alexandergdot123/warp-simd-fpga-gpu/media/Screenshot 2026-07-18 125612.png

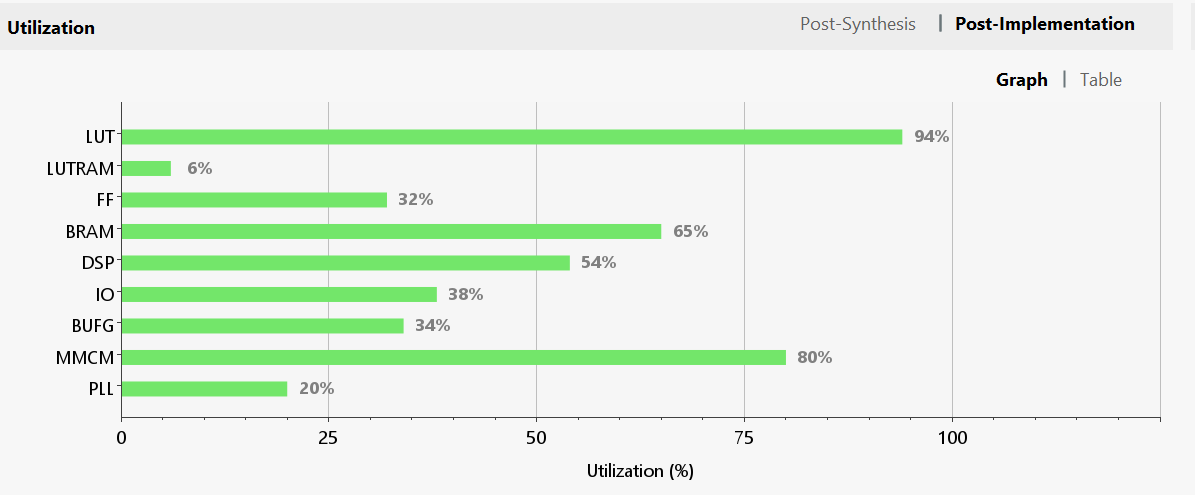
media/Screenshot 2026-07-18 125612.png
