alexandergdot123/warp-simd-fpga-gpu/hw/fullSystemTop.xdc

create_clock -period 10.000 -name clk_100 -waveform {0.000 5.000} [get_ports Clk]
# =========================
# GPU clock (clk_slow_creator)
# =========================
create_generated_clock -name gpu_clk -source [get_pins clk_slow_creator_inst/inst/clk_in1] [get_pins clk_slow_creator_inst/inst/clk_out1]

set_clock_groups -asynchronous -group [get_clocks gpu_clk] -group [get_clocks -exclude gpu_clk *]

set_property IOSTANDARD LVCMOS33 [get_ports Clk]
set_property IOSTANDARD LVCMOS25 [get_ports reset_rtl_0]
set_property IOSTANDARD LVCMOS33 [get_ports uart_rtl_0_rxd]
set_property IOSTANDARD LVCMOS33 [get_ports uart_rtl_0_txd]
set_property PACKAGE_PIN N15 [get_ports Clk]
set_property PACKAGE_PIN J2 [get_ports reset_rtl_0]
set_property PACKAGE_PIN B16 [get_ports uart_rtl_0_rxd]
set_property PACKAGE_PIN A16 [get_ports uart_rtl_0_txd]

set_property IOSTANDARD LVCMOS33 [get_ports {gpio_usb_int_tri_i[0]}]
set_property IOSTANDARD LVCMOS33 [get_ports usb_spi_miso]
set_property IOSTANDARD LVCMOS33 [get_ports usb_spi_mosi]
set_property IOSTANDARD LVCMOS33 [get_ports usb_spi_sclk]
set_property PACKAGE_PIN T13 [get_ports {gpio_usb_int_tri_i[0]}]
set_property PACKAGE_PIN V14 [get_ports usb_spi_sclk]
set_property PACKAGE_PIN V15 [get_ports usb_spi_mosi]
set_property PACKAGE_PIN U12 [get_ports usb_spi_miso]

set_property IOSTANDARD LVCMOS33 [get_ports gpio_usb_rst_tri_o]
set_property PACKAGE_PIN V13 [get_ports gpio_usb_rst_tri_o]
set_property PACKAGE_PIN T12 [get_ports usb_spi_ss]
set_property IOSTANDARD LVCMOS33 [get_ports usb_spi_ss]


#HDMI Signals
set_property -dict {PACKAGE_PIN V17 IOSTANDARD TMDS_33} [get_ports hdmi_tmds_clk_n]
set_property -dict {PACKAGE_PIN U16 IOSTANDARD TMDS_33} [get_ports hdmi_tmds_clk_p]

set_property -dict {PACKAGE_PIN U18 IOSTANDARD TMDS_33} [get_ports {hdmi_tmds_data_n[0]}]
set_property -dict {PACKAGE_PIN R17 IOSTANDARD TMDS_33} [get_ports {hdmi_tmds_data_n[1]}]
set_property -dict {PACKAGE_PIN T14 IOSTANDARD TMDS_33} [get_ports {hdmi_tmds_data_n[2]}]

set_property -dict {PACKAGE_PIN U17 IOSTANDARD TMDS_33} [get_ports {hdmi_tmds_data_p[0]}]
set_property -dict {PACKAGE_PIN R16 IOSTANDARD TMDS_33} [get_ports {hdmi_tmds_data_p[1]}]
set_property -dict {PACKAGE_PIN R14 IOSTANDARD TMDS_33} [get_ports {hdmi_tmds_data_p[2]}]














##################################################################################################
## LP_DDR3 INTERFACE FOR THE URBANA BOARD based on the July 18 2022 schematic
## Memory Device: DDR3_SDRAM->Components->MT41K256M16XX-15E
## Data Width: 16
## Time Period: 2500
## Data Mask: 1
## Rick Ballantyne AMD July25 2022 NOT HARDWARE VERIFIED
##################################################################################################
############## NET - IOSTANDARD ##################

# PadFunction: IO_L12P_T1_MRCC_14 (SCHEMATIC CLK_100MHZ)
#set_property IOSTANDARD LVCMOS33 [get_ports clk_ref_i]
#set_property PACKAGE_PIN N15 [get_ports clk_ref_i] #overlap
#create_clock -period 10.000 [get_ports clk_ref_i]


# PadFunction: IO_L12N_T1_MRCC_16 (SCHEMATIC RGB0_G)
set_property IOSTANDARD LVCMOS33 [get_ports ram_init_done]
set_property PACKAGE_PIN A9 [get_ports ram_init_done]

# PadFunction: IO_L14N_T2_SRCC_16 (SCHEMATIC RGB1_R)
set_property IOSTANDARD LVCMOS33 [get_ports ram_init_error]
set_property PACKAGE_PIN A11 [get_ports ram_init_error]

# Set SPI buswidth
set_property BITSTREAM.CONFIG.SPI_BUSWIDTH 4 [current_design]

set_property -dict {PACKAGE_PIN M16 IOSTANDARD LVCMOS33} [get_ports sd_miso]
set_property -dict {PACKAGE_PIN N18 IOSTANDARD LVCMOS33} [get_ports sd_cs]
set_property -dict {PACKAGE_PIN P17 IOSTANDARD LVCMOS33} [get_ports sd_mosi]
set_property -dict {PACKAGE_PIN P18 IOSTANDARD LVCMOS33} [get_ports sd_sclk]

# PadFunction: IO_L1N_T0_34 (SCHEMATIC DDR_DQ0)
set_property SLEW FAST [get_ports {ddr3_dq[0]}]
set_property IN_TERM UNTUNED_SPLIT_50 [get_ports {ddr3_dq[0]}]
set_property IOSTANDARD SSTL135 [get_ports {ddr3_dq[0]}]
set_property PACKAGE_PIN K2 [get_ports {ddr3_dq[0]}]

# PadFunction: IO_L2P_T0_34 (SCHEMATIC DDR_DQ1)
set_property SLEW FAST [get_ports {ddr3_dq[1]}]
set_property IN_TERM UNTUNED_SPLIT_50 [get_ports {ddr3_dq[1]}]
set_property IOSTANDARD SSTL135 [get_ports {ddr3_dq[1]}]
set_property PACKAGE_PIN M4 [get_ports {ddr3_dq[1]}]

# PadFunction: IO_L2N_T0_34 (SCHEMATIC DDR_DQ2)
set_property SLEW FAST [get_ports {ddr3_dq[2]}]
set_property IN_TERM UNTUNED_SPLIT_50 [get_ports {ddr3_dq[2]}]
set_property IOSTANDARD SSTL135 [get_ports {ddr3_dq[2]}]
set_property PACKAGE_PIN K3 [get_ports {ddr3_dq[2]}]

# PadFunction: IO_L4P_T0_34 (SCHEMATIC DDR_DQ3)
set_property SLEW FAST [get_ports {ddr3_dq[3]}]
set_property IN_TERM UNTUNED_SPLIT_50 [get_ports {ddr3_dq[3]}]
set_property IOSTANDARD SSTL135 [get_ports {ddr3_dq[3]}]
set_property PACKAGE_PIN L5 [get_ports {ddr3_dq[3]}]

# PadFunction: IO_L4N_T0_34 (SCHEMATIC DDR_DQ4)
set_property SLEW FAST [get_ports {ddr3_dq[4]}]
set_property IN_TERM UNTUNED_SPLIT_50 [get_ports {ddr3_dq[4]}]
set_property IOSTANDARD SSTL135 [get_ports {ddr3_dq[4]}]
set_property PACKAGE_PIN L6 [get_ports {ddr3_dq[4]}]

# PadFunction: IO_L5P_T0_34 (SCHEMATIC DDR_DQ5)
set_property SLEW FAST [get_ports {ddr3_dq[5]}]
set_property IN_TERM UNTUNED_SPLIT_50 [get_ports {ddr3_dq[5]}]
set_property IOSTANDARD SSTL135 [get_ports {ddr3_dq[5]}]
set_property PACKAGE_PIN M6 [get_ports {ddr3_dq[5]}]

# PadFunction: IO_L5N_T0_34 (SCHEMATIC DDR_DQ6)
set_property SLEW FAST [get_ports {ddr3_dq[6]}]
set_property IN_TERM UNTUNED_SPLIT_50 [get_ports {ddr3_dq[6]}]
set_property IOSTANDARD SSTL135 [get_ports {ddr3_dq[6]}]
set_property PACKAGE_PIN L4 [get_ports {ddr3_dq[6]}]

# PadFunction: IO_L6P_T0_34 (SCHEMATIC DDR_DQ7)
set_property SLEW FAST [get_ports {ddr3_dq[7]}]
set_property IN_TERM UNTUNED_SPLIT_50 [get_ports {ddr3_dq[7]}]
set_property IOSTANDARD SSTL135 [get_ports {ddr3_dq[7]}]
set_property PACKAGE_PIN K6 [get_ports {ddr3_dq[7]}]

# PadFunction: IO_L7N_T1_34 (SCHEMATIC DDR_DQ8)
set_property SLEW FAST [get_ports {ddr3_dq[8]}]
set_property IN_TERM UNTUNED_SPLIT_50 [get_ports {ddr3_dq[8]}]
set_property IOSTANDARD SSTL135 [get_ports {ddr3_dq[8]}]
set_property PACKAGE_PIN N5 [get_ports {ddr3_dq[8]}]

# PadFunction: IO_L8P_T1_34 (SCHEMATIC DDR_DQ9)
set_property SLEW FAST [get_ports {ddr3_dq[9]}]
set_property IN_TERM UNTUNED_SPLIT_50 [get_ports {ddr3_dq[9]}]
set_property IOSTANDARD SSTL135 [get_ports {ddr3_dq[9]}]
set_property PACKAGE_PIN M1 [get_ports {ddr3_dq[9]}]

# PadFunction: IO_L8N_T1_34 (SCHEMATIC DDR_DQ10)
set_property SLEW FAST [get_ports {ddr3_dq[10]}]
set_property IN_TERM UNTUNED_SPLIT_50 [get_ports {ddr3_dq[10]}]
set_property IOSTANDARD SSTL135 [get_ports {ddr3_dq[10]}]
set_property PACKAGE_PIN P1 [get_ports {ddr3_dq[10]}]

# PadFunction: IO_L10P_T1_34 (SCHEMATIC DDR_DQ11)
set_property SLEW FAST [get_ports {ddr3_dq[11]}]
set_property IN_TERM UNTUNED_SPLIT_50 [get_ports {ddr3_dq[11]}]
set_property IOSTANDARD SSTL135 [get_ports {ddr3_dq[11]}]
set_property PACKAGE_PIN N1 [get_ports {ddr3_dq[11]}]

# PadFunction: IO_L10N_T1_34 (SCHEMATIC DDR_DQ12)
set_property SLEW FAST [get_ports {ddr3_dq[12]}]
set_property IN_TERM UNTUNED_SPLIT_50 [get_ports {ddr3_dq[12]}]
set_property IOSTANDARD SSTL135 [get_ports {ddr3_dq[12]}]
set_property PACKAGE_PIN R2 [get_ports {ddr3_dq[12]}]

# PadFunction: IO_L11P_T1_SRCC_34 (SCHEMATIC DDR_DQ13)
set_property SLEW FAST [get_ports {ddr3_dq[13]}]
set_property IN_TERM UNTUNED_SPLIT_50 [get_ports {ddr3_dq[13]}]
set_property IOSTANDARD SSTL135 [get_ports {ddr3_dq[13]}]
set_property PACKAGE_PIN N4 [get_ports {ddr3_dq[13]}]

# PadFunction: IO_L11N_T1_SRCC_34 (SCHEMATIC DDR_DQ14)
set_property SLEW FAST [get_ports {ddr3_dq[14]}]
set_property IN_TERM UNTUNED_SPLIT_50 [get_ports {ddr3_dq[14]}]
set_property IOSTANDARD SSTL135 [get_ports {ddr3_dq[14]}]
set_property PACKAGE_PIN P2 [get_ports {ddr3_dq[14]}]

# PadFunction: IO_L12P_T1_MRCC_34 (SCHEMATIC DDR_DQ15)
set_property SLEW FAST [get_ports {ddr3_dq[15]}]
set_property IN_TERM UNTUNED_SPLIT_50 [get_ports {ddr3_dq[15]}]
set_property IOSTANDARD SSTL135 [get_ports {ddr3_dq[15]}]
set_property PACKAGE_PIN M2 [get_ports {ddr3_dq[15]}]

# PadFunction: IO_L13P_T2_MRCC_34 (SCHEMATIC DDR_A14)
#set_property SLEW FAST [get_ports {ddr3_addr[14]}]
#set_property IOSTANDARD SSTL135 [get_ports {ddr3_addr[14]}]
#set_property PACKAGE_PIN R6 [get_ports {ddr3_addr[14]}]

# PadFunction: IO_L13N_T2_MRCC_34 (SCHEMATIC DDR_A13)
#set_property SLEW FAST [get_ports {ddr3_addr[13]}]
#set_property IOSTANDARD SSTL135 [get_ports {ddr3_addr[13]}]
#set_property PACKAGE_PIN V7 [get_ports {ddr3_addr[13]}]

# PadFunction: IO_L14P_T2_SRCC_34 (SCHEMATIC DDR_A12)
set_property SLEW FAST [get_ports {ddr3_addr[12]}]
set_property IOSTANDARD SSTL135 [get_ports {ddr3_addr[12]}]
set_property PACKAGE_PIN V6 [get_ports {ddr3_addr[12]}]

# PadFunction: IO_L14N_T2_SRCC_34 (SCHEMATIC DDR_A11)
set_property SLEW FAST [get_ports {ddr3_addr[11]}]
set_property IOSTANDARD SSTL135 [get_ports {ddr3_addr[11]}]
set_property PACKAGE_PIN P5 [get_ports {ddr3_addr[11]}]

# PadFunction: IO_L15P_T2_DQS_34 (SCHEMATIC DDR_A10)
set_property SLEW FAST [get_ports {ddr3_addr[10]}]
set_property IOSTANDARD SSTL135 [get_ports {ddr3_addr[10]}]
set_property PACKAGE_PIN U3 [get_ports {ddr3_addr[10]}]

# PadFunction: IO_L15N_T2_DQS_34 (SCHEMATIC DDR_A9)
set_property SLEW FAST [get_ports {ddr3_addr[9]}]
set_property IOSTANDARD SSTL135 [get_ports {ddr3_addr[9]}]
set_property PACKAGE_PIN U6 [get_ports {ddr3_addr[9]}]

# PadFunction: IO_L16P_T2_34 (SCHEMATIC DDR_A8)
set_property SLEW FAST [get_ports {ddr3_addr[8]}]
set_property IOSTANDARD SSTL135 [get_ports {ddr3_addr[8]}]
set_property PACKAGE_PIN R7 [get_ports {ddr3_addr[8]}]

# PadFunction: IO_L16N_T2_34 (SCHEMATIC DDR_A7)
set_property SLEW FAST [get_ports {ddr3_addr[7]}]
set_property IOSTANDARD SSTL135 [get_ports {ddr3_addr[7]}]
set_property PACKAGE_PIN U7 [get_ports {ddr3_addr[7]}]

# PadFunction: IO_L17P_T2_34 (SCHEMATIC DDR_A6)
set_property SLEW FAST [get_ports {ddr3_addr[6]}]
set_property IOSTANDARD SSTL135 [get_ports {ddr3_addr[6]}]
set_property PACKAGE_PIN V5 [get_ports {ddr3_addr[6]}]

# PadFunction: IO_L17N_T2_34 (SCHEMATIC DDR_A5)
set_property SLEW FAST [get_ports {ddr3_addr[5]}]
set_property IOSTANDARD SSTL135 [get_ports {ddr3_addr[5]}]
set_property PACKAGE_PIN T1 [get_ports {ddr3_addr[5]}]

# PadFunction: IO_L18P_T2_34 (SCHEMATIC DDR_A4)
set_property SLEW FAST [get_ports {ddr3_addr[4]}]
set_property IOSTANDARD SSTL135 [get_ports {ddr3_addr[4]}]
set_property PACKAGE_PIN T6 [get_ports {ddr3_addr[4]}]

# PadFunction: IO_L18N_T2_34 (SCHEMATIC DDR_A3)
set_property SLEW FAST [get_ports {ddr3_addr[3]}]
set_property IOSTANDARD SSTL135 [get_ports {ddr3_addr[3]}]
set_property PACKAGE_PIN T3 [get_ports {ddr3_addr[3]}]

# PadFunction: IO_L19P_T3_34 (SCHEMATIC DDR_A2)
set_property SLEW FAST [get_ports {ddr3_addr[2]}]
set_property IOSTANDARD SSTL135 [get_ports {ddr3_addr[2]}]
set_property PACKAGE_PIN P6 [get_ports {ddr3_addr[2]}]

# PadFunction: IO_L19N_T3_VREF_34 (SCHEMATIC DDR_A1)
set_property SLEW FAST [get_ports {ddr3_addr[1]}]
set_property IOSTANDARD SSTL135 [get_ports {ddr3_addr[1]}]
set_property PACKAGE_PIN R4 [get_ports {ddr3_addr[1]}]

# PadFunction: IO_L20P_T3_34 (SCHEMATIC DDR_A0)
set_property SLEW FAST [get_ports {ddr3_addr[0]}]
set_property IOSTANDARD SSTL135 [get_ports {ddr3_addr[0]}]
set_property PACKAGE_PIN V3 [get_ports {ddr3_addr[0]}]

# PadFunction: IO_L20N_T3_34 (SCHEMATIC DDR_BA2)
set_property SLEW FAST [get_ports {ddr3_ba[2]}]
set_property IOSTANDARD SSTL135 [get_ports {ddr3_ba[2]}]
set_property PACKAGE_PIN R3 [get_ports {ddr3_ba[2]}]

# PadFunction: IO_L22P_T3_34 (SCHEMATIC DDR_BA1)
set_property SLEW FAST [get_ports {ddr3_ba[1]}]
set_property IOSTANDARD SSTL135 [get_ports {ddr3_ba[1]}]
set_property PACKAGE_PIN V4 [get_ports {ddr3_ba[1]}]

# PadFunction: IO_L22N_T3_34 (SCHEMATIC DDR_BA0)
set_property SLEW FAST [get_ports {ddr3_ba[0]}]
set_property IOSTANDARD SSTL135 [get_ports {ddr3_ba[0]}]
set_property PACKAGE_PIN V2 [get_ports {ddr3_ba[0]}]

# PadFunction: IO_L23P_T3_34 (SCHEMATIC DDR_RAS_B
set_property SLEW FAST [get_ports ddr3_ras_n]
set_property IOSTANDARD SSTL135 [get_ports ddr3_ras_n]
set_property PACKAGE_PIN U2 [get_ports ddr3_ras_n]

# PadFunction: IO_L23N_T3_34 (SCHEMATIC DDR_CAS_B)
set_property SLEW FAST [get_ports ddr3_cas_n]
set_property IOSTANDARD SSTL135 [get_ports ddr3_cas_n]
set_property PACKAGE_PIN U1 [get_ports ddr3_cas_n]

# PadFunction: IO_L24P_T3_34 (SCHEMATIC DDR_WE_B)
set_property SLEW FAST [get_ports ddr3_we_n]
set_property IOSTANDARD SSTL135 [get_ports ddr3_we_n]
set_property PACKAGE_PIN T2 [get_ports ddr3_we_n]

# PadFunction: IO_L6N_T0_VREF_34 (SCHEMATIC DDR_RESET_B)
set_property SLEW FAST [get_ports ddr3_reset_n]
set_property IOSTANDARD SSTL135 [get_ports ddr3_reset_n]
set_property PACKAGE_PIN M5 [get_ports ddr3_reset_n]

# PadFunction: IO_L24N_T3_34 (SCHEMATIC DDR_CKE)
set_property SLEW FAST [get_ports {ddr3_cke[0]}]
set_property IOSTANDARD SSTL135 [get_ports {ddr3_cke[0]}]
set_property PACKAGE_PIN T5 [get_ports {ddr3_cke[0]}]

# PadFunction: IO_25_34 (SCHEMATIC DDR_ODT)
set_property SLEW FAST [get_ports {ddr3_odt[0]}]
set_property IOSTANDARD SSTL135 [get_ports {ddr3_odt[0]}]
set_property PACKAGE_PIN P7 [get_ports {ddr3_odt[0]}]

# PadFunction: IO_L1P_T0_34 (SCHEMATIC DDR_LDM)
set_property SLEW FAST [get_ports {ddr3_dm[0]}]
set_property IOSTANDARD SSTL135 [get_ports {ddr3_dm[0]}]
set_property PACKAGE_PIN K4 [get_ports {ddr3_dm[0]}]

# PadFunction: IO_L7P_T1_34 (SCHEMATIC DDR_UDM)
set_property SLEW FAST [get_ports {ddr3_dm[1]}]
set_property IOSTANDARD SSTL135 [get_ports {ddr3_dm[1]}]
set_property PACKAGE_PIN M3 [get_ports {ddr3_dm[1]}]

# PadFunction: IO_L12P_T1_MRCC_35 (SCHEMATIC DDR_REF_CLK_P)
#set_property IOSTANDARD LVDS_25 [get_ports sys_clk_p]

# PadFunction: IO_L12N_T1_MRCC_35 (SCHEMATIC DDR_REF_CLK_N)
#set_property IOSTANDARD LVDS_25 [get_ports sys_clk_n]
#set_property PACKAGE_PIN C1 [get_ports sys_clk_p]
#set_property PACKAGE_PIN B1 [get_ports sys_clk_n]

# PadFunction: IO_L3P_T0_DQS_34 (SCHEMATIC DDR_LDQS_P)
set_property SLEW FAST [get_ports {ddr3_dqs_p[0]}]
set_property IN_TERM UNTUNED_SPLIT_50 [get_ports {ddr3_dqs_p[0]}]
set_property IOSTANDARD DIFF_SSTL135 [get_ports {ddr3_dqs_p[0]}]

# PadFunction: IO_L3N_T0_DQS_34 (SCHEMATIC DDR_LDQS_N)
set_property SLEW FAST [get_ports {ddr3_dqs_n[0]}]
set_property IN_TERM UNTUNED_SPLIT_50 [get_ports {ddr3_dqs_n[0]}]
set_property IOSTANDARD DIFF_SSTL135 [get_ports {ddr3_dqs_n[0]}]
set_property PACKAGE_PIN K1 [get_ports {ddr3_dqs_p[0]}]
set_property PACKAGE_PIN L1 [get_ports {ddr3_dqs_n[0]}]

# PadFunction: IO_L9P_T1_DQS_34 (SCHEMATIC DDR_UDQS_P)
set_property SLEW FAST [get_ports {ddr3_dqs_p[1]}]
set_property IN_TERM UNTUNED_SPLIT_50 [get_ports {ddr3_dqs_p[1]}]
set_property IOSTANDARD DIFF_SSTL135 [get_ports {ddr3_dqs_p[1]}]

# PadFunction: IO_L9N_T1_DQS_34 (SCHEMATIC DDR_UDQS_N)
set_property SLEW FAST [get_ports {ddr3_dqs_n[1]}]
set_property IN_TERM UNTUNED_SPLIT_50 [get_ports {ddr3_dqs_n[1]}]
set_property IOSTANDARD DIFF_SSTL135 [get_ports {ddr3_dqs_n[1]}]
set_property PACKAGE_PIN N3 [get_ports {ddr3_dqs_p[1]}]
set_property PACKAGE_PIN N2 [get_ports {ddr3_dqs_n[1]}]

# PadFunction: IO_L21P_T3_DQS_34 (SCHEMATIC DDR_CLK_P)
set_property SLEW FAST [get_ports {ddr3_ck_p[0]}]
set_property IOSTANDARD DIFF_SSTL135 [get_ports {ddr3_ck_p[0]}]

# PadFunction: IO_L21N_T3_DQS_34 (SCHEMATIC DDR_CLK_N)
set_property SLEW FAST [get_ports {ddr3_ck_n[0]}]
set_property IOSTANDARD DIFF_SSTL135 [get_ports {ddr3_ck_n[0]}]
set_property PACKAGE_PIN R5 [get_ports {ddr3_ck_p[0]}]
set_property PACKAGE_PIN T4 [get_ports {ddr3_ck_n[0]}]

set_property INTERNAL_VREF 0.675 [get_iobanks 34]





connect_debug_port u_ila_0/probe0 [get_nets [list {memoryController_inst/writeCounter_debug_vga[0]} {memoryController_inst/writeCounter_debug_vga[1]} {memoryController_inst/writeCounter_debug_vga[2]} {memoryController_inst/writeCounter_debug_vga[3]} {memoryController_inst/writeCounter_debug_vga[4]} {memoryController_inst/writeCounter_debug_vga[5]} {memoryController_inst/writeCounter_debug_vga[6]} {memoryController_inst/writeCounter_debug_vga[7]} {memoryController_inst/writeCounter_debug_vga[8]} {memoryController_inst/writeCounter_debug_vga[9]}]]
connect_debug_port u_ila_0/probe1 [get_nets [list {memoryController_inst/curStateDebug_debug_vga[0]} {memoryController_inst/curStateDebug_debug_vga[1]}]]

connect_debug_port u_ila_0/probe1 [get_nets [list {memoryController_inst/rowColPlusFrameBuf_debug_vga[0]} {memoryController_inst/rowColPlusFrameBuf_debug_vga[1]} {memoryController_inst/rowColPlusFrameBuf_debug_vga[2]} {memoryController_inst/rowColPlusFrameBuf_debug_vga[3]} {memoryController_inst/rowColPlusFrameBuf_debug_vga[4]} {memoryController_inst/rowColPlusFrameBuf_debug_vga[5]} {memoryController_inst/rowColPlusFrameBuf_debug_vga[6]} {memoryController_inst/rowColPlusFrameBuf_debug_vga[7]} {memoryController_inst/rowColPlusFrameBuf_debug_vga[8]} {memoryController_inst/rowColPlusFrameBuf_debug_vga[9]} {memoryController_inst/rowColPlusFrameBuf_debug_vga[10]} {memoryController_inst/rowColPlusFrameBuf_debug_vga[11]} {memoryController_inst/rowColPlusFrameBuf_debug_vga[12]} {memoryController_inst/rowColPlusFrameBuf_debug_vga[13]}]]



connect_debug_port u_ila_0/probe0 [get_nets [list {memoryController_inst/frozen_row_col_index_reg_debug_vga[0]} {memoryController_inst/frozen_row_col_index_reg_debug_vga[1]} {memoryController_inst/frozen_row_col_index_reg_debug_vga[2]} {memoryController_inst/frozen_row_col_index_reg_debug_vga[3]} {memoryController_inst/frozen_row_col_index_reg_debug_vga[4]} {memoryController_inst/frozen_row_col_index_reg_debug_vga[5]} {memoryController_inst/frozen_row_col_index_reg_debug_vga[6]} {memoryController_inst/frozen_row_col_index_reg_debug_vga[7]} {memoryController_inst/frozen_row_col_index_reg_debug_vga[8]} {memoryController_inst/frozen_row_col_index_reg_debug_vga[9]} {memoryController_inst/frozen_row_col_index_reg_debug_vga[10]}]]
connect_debug_port u_ila_0/probe1 [get_nets [list {memoryController_inst/alexMemEnable_debug_vga[0]} {memoryController_inst/alexMemEnable_debug_vga[1]}]]
connect_debug_port u_ila_0/probe2 [get_nets [list {memoryController_inst/alexAddress_debug_vga[0]} {memoryController_inst/alexAddress_debug_vga[1]} {memoryController_inst/alexAddress_debug_vga[2]} {memoryController_inst/alexAddress_debug_vga[3]} {memoryController_inst/alexAddress_debug_vga[4]} {memoryController_inst/alexAddress_debug_vga[5]} {memoryController_inst/alexAddress_debug_vga[6]} {memoryController_inst/alexAddress_debug_vga[7]} {memoryController_inst/alexAddress_debug_vga[8]} {memoryController_inst/alexAddress_debug_vga[9]} {memoryController_inst/alexAddress_debug_vga[10]} {memoryController_inst/alexAddress_debug_vga[11]} {memoryController_inst/alexAddress_debug_vga[12]} {memoryController_inst/alexAddress_debug_vga[13]} {memoryController_inst/alexAddress_debug_vga[14]} {memoryController_inst/alexAddress_debug_vga[15]} {memoryController_inst/alexAddress_debug_vga[16]} {memoryController_inst/alexAddress_debug_vga[17]} {memoryController_inst/alexAddress_debug_vga[18]} {memoryController_inst/alexAddress_debug_vga[19]} {memoryController_inst/alexAddress_debug_vga[20]} {memoryController_inst/alexAddress_debug_vga[21]} {memoryController_inst/alexAddress_debug_vga[22]} {memoryController_inst/alexAddress_debug_vga[23]}]]
connect_debug_port u_ila_0/probe3 [get_nets [list {memoryController_inst/drawX_debug_vga[0]} {memoryController_inst/drawX_debug_vga[1]} {memoryController_inst/drawX_debug_vga[2]} {memoryController_inst/drawX_debug_vga[3]} {memoryController_inst/drawX_debug_vga[4]} {memoryController_inst/drawX_debug_vga[5]} {memoryController_inst/drawX_debug_vga[6]} {memoryController_inst/drawX_debug_vga[7]} {memoryController_inst/drawX_debug_vga[8]} {memoryController_inst/drawX_debug_vga[9]}]]
connect_debug_port u_ila_0/probe4 [get_nets [list {memoryController_inst/drawY_debug_vga[0]} {memoryController_inst/drawY_debug_vga[1]} {memoryController_inst/drawY_debug_vga[2]} {memoryController_inst/drawY_debug_vga[3]} {memoryController_inst/drawY_debug_vga[4]} {memoryController_inst/drawY_debug_vga[5]} {memoryController_inst/drawY_debug_vga[6]} {memoryController_inst/drawY_debug_vga[7]} {memoryController_inst/drawY_debug_vga[8]} {memoryController_inst/drawY_debug_vga[9]}]]
connect_debug_port u_ila_0/probe5 [get_nets [list {memoryController_inst/readCounter_debug_vga[0]} {memoryController_inst/readCounter_debug_vga[1]} {memoryController_inst/readCounter_debug_vga[2]} {memoryController_inst/readCounter_debug_vga[3]} {memoryController_inst/readCounter_debug_vga[4]} {memoryController_inst/readCounter_debug_vga[5]} {memoryController_inst/readCounter_debug_vga[6]} {memoryController_inst/readCounter_debug_vga[7]} {memoryController_inst/readCounter_debug_vga[8]} {memoryController_inst/readCounter_debug_vga[9]}]]
connect_debug_port u_ila_0/probe7 [get_nets [list {memoryController_inst/writeCounter_debug_vga[0]} {memoryController_inst/writeCounter_debug_vga[1]} {memoryController_inst/writeCounter_debug_vga[2]} {memoryController_inst/writeCounter_debug_vga[3]} {memoryController_inst/writeCounter_debug_vga[4]} {memoryController_inst/writeCounter_debug_vga[5]} {memoryController_inst/writeCounter_debug_vga[6]} {memoryController_inst/writeCounter_debug_vga[7]} {memoryController_inst/writeCounter_debug_vga[8]} {memoryController_inst/writeCounter_debug_vga[9]}]]
connect_debug_port u_ila_0/probe9 [get_nets [list memoryController_inst/alexCommandAcknowledged_debug_vga]]
connect_debug_port u_ila_0/probe12 [get_nets [list memoryController_inst/alexFinishedMemAction_debug_vga]]
connect_debug_port u_ila_0/probe14 [get_nets [list memoryController_inst/alexNewCommand_debug_vga]]
connect_debug_port u_ila_0/probe16 [get_nets [list memoryController_inst/processingAlexCommand_debug_vga]]
connect_debug_port u_ila_0/probe26 [get_nets [list memoryController_inst/vgaLoadWhenReady_debug_vga]]
# On-board LEDs
set_property -dict {PACKAGE_PIN C13 IOSTANDARD LVCMOS33} [get_ports {led[0]}]
set_property -dict {PACKAGE_PIN C14 IOSTANDARD LVCMOS33} [get_ports {led[1]}]
set_property -dict {PACKAGE_PIN D14 IOSTANDARD LVCMOS33} [get_ports {led[2]}]
set_property -dict {PACKAGE_PIN D15 IOSTANDARD LVCMOS33} [get_ports {led[3]}]
set_property -dict {PACKAGE_PIN D16 IOSTANDARD LVCMOS33} [get_ports {led[4]}]
set_property -dict {PACKAGE_PIN F18 IOSTANDARD LVCMOS33} [get_ports {led[5]}]
set_property -dict {PACKAGE_PIN E17 IOSTANDARD LVCMOS33} [get_ports {led[6]}]
set_property -dict {PACKAGE_PIN D17 IOSTANDARD LVCMOS33} [get_ports {led[7]}]
set_property -dict {PACKAGE_PIN C17 IOSTANDARD LVCMOS33} [get_ports {led[8]}]
set_property -dict {PACKAGE_PIN B18 IOSTANDARD LVCMOS33} [get_ports {led[9]}]
set_property -dict {PACKAGE_PIN A17 IOSTANDARD LVCMOS33} [get_ports {led[10]}]
set_property -dict {PACKAGE_PIN B17 IOSTANDARD LVCMOS33} [get_ports {led[11]}]
set_property -dict {PACKAGE_PIN C18 IOSTANDARD LVCMOS33} [get_ports {led[12]}]
set_property -dict {PACKAGE_PIN D18 IOSTANDARD LVCMOS33} [get_ports {led[13]}]
set_property -dict {PACKAGE_PIN E18 IOSTANDARD LVCMOS33} [get_ports {led[14]}]
set_property -dict {PACKAGE_PIN G17 IOSTANDARD LVCMOS33} [get_ports {led[15]}]
