alexandergdot123/warp-simd-fpga-gpu/rtl/regFile.sv

module twoReadOneWriteRegFile_0 (
    input  logic clk, input logic rst, input logic [7:0] sr1_sel, input logic [7:0] sr2_sel,
    output logic [31:0] sr1, output logic [31:0] sr2, input logic [7:0] dr_sel, input logic [31:0] dr, input logic dr_en);
    bram_regfile_inst_0 u_regfile_read2  (
        .clka(clk), .ena(dr_en && ~(dr_sel[3:0]==4'hF)), .wea(dr_en && ~(dr_sel[3:0]==4'hF)), 
        .addra(dr_sel), .dina(dr), .clkb(clk), .enb(1'b1), .addrb(sr1_sel), .doutb(sr1));
    bram_regfile_inst_0 u_regfile_read1  (
        .clka(clk), .ena(dr_en && ~(dr_sel[3:0]==4'hF)), .wea(dr_en && ~(dr_sel[3:0]==4'hF)), 
        .addra(dr_sel), .dina(dr), .clkb(clk), .enb(1'b1), .addrb(sr2_sel), .doutb(sr2));
endmodule


module twoReadOneWriteRegFile_1 (
    input  logic clk, input logic rst, input logic [7:0] sr1_sel, input logic [7:0] sr2_sel,
    output logic [31:0] sr1, output logic [31:0] sr2, input logic [7:0] dr_sel, input logic [31:0] dr, input logic dr_en);
    bram_regfile_inst_1 u_regfile_read2  (
        .clka(clk), .ena(dr_en && ~(dr_sel[3:0]==4'hF)), .wea(dr_en && ~(dr_sel[3:0]==4'hF)), 
        .addra(dr_sel), .dina(dr), .clkb(clk), .enb(1'b1), .addrb(sr1_sel), .doutb(sr1));
    bram_regfile_inst_1 u_regfile_read1  (
        .clka(clk), .ena(dr_en && ~(dr_sel[3:0]==4'hF)), .wea(dr_en && ~(dr_sel[3:0]==4'hF)), 
        .addra(dr_sel), .dina(dr), .clkb(clk), .enb(1'b1), .addrb(sr2_sel), .doutb(sr2));
endmodule


module twoReadOneWriteRegFile_2 (
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
    bram_regfile_inst_19 u_regfile_read1  (
        .clka(clk), .ena(dr_en && ~(dr_sel[3:0]==4'hF)), .wea(dr_en && ~(dr_sel[3:0]==4'hF)), 
        .addra(dr_sel), .dina(dr), .clkb(clk), .enb(1'b1), .addrb(sr2_sel), .doutb(sr2));
endmodule
