alexandergdot123/warp-simd-fpga-gpu/(commit log)

2026-07-18 Initial commit: SIMT GPU assembler and firmware driver
    Rust assembler for the custom 32-bit GPU ISA, .s test programs for the
    tile rasterizer/framebuffer clear/color LUT setup, and the Zynq host
    firmware that drives the GPU over its command FIFO with a fixed-point
    3D pipeline. RTL to follow.
    [main.c, main.rs, ppm_to_mem.c, trace_gen.c]
2026-07-18 Add GPU core RTL
    SIMT cluster/scheduler, register files, load/store and divide units,
    AXI4-Lite integration (warp_gpu_v1_0 IP), and board-level top with
    DDR3/HDMI wiring. Sourced from the actively-developed copy of the
    design (ip_repo/warp_gpu_1_0/src and pipelined_gpu.srcs/sources_1/new),
    picking the newer version of each file where an older duplicate existed
    elsewhere in the Vivado project.
    [axi_wrapper.sv, cdcFifo.sv, cluster.sv, divide.sv, fullGPUSystem.sv, lane.sv, load_store.sv, memController.sv]
2026-07-18 Expand README architecture detail
    Move multiply/divide out of the ALU class (separate execution units).
    Document the memory coalescer, load/store pipelining, runtime-
    programmable core clock (80 MHz), scheduler policy (round-robin with
    lookahead, greedy-then-oldest issue), the shared instruction buffer,
    runtime context reconfiguration via barrier, dual framebuffers, VGA/
    GPU memory arbitration, and AXI status register layout.
2026-07-18 Add third-party SD card/HDMI TX deps, fix videoController.sv, add setup steps + contact
    videoController.sv was wrongly excluded earlier as third-party cruft;
    it's actively instantiated by fullGPUSystem.sv and is the current
    project's own file, so it moves into rtl/. Adds the SD card
    preload chain (sdcard_init.sv, SDCard.vhd) and RealDigital HDMI TX IP
    under third_party/, carried over from the previous project iteration
    per its README's acknowledgments (excluding rtl_ddr3_top.sv and
    ram_reader.sv, which were rewritten from scratch). Adds a setup/steps
    section documenting BRAM instantiation requirements (simple dual-port,
    256-deep register files, byte-enabled shared memory) and a contact
    secti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
    [videoController.sv]
2026-07-18 Remove em-dashes, add HDMI/30FPS framing, fixed-point mul/div note, DDR3 SD-preload capability note, compile-time parameters, and concrete in-flight load/store counts
    - Zero em-dashes across all README files (replaced with colons/commas/
    periods as appropriate).
    - State up front that output is HDMI to a real monitor, 640x480 @ 30 FPS.
    - Note that fixed-point (Q16.16) operands require compression to 16-bit
    before multiply/divide can operate on them.
    - Note DDR3 SD-card preloading could in theory support texture
    offload/a texture-mapped triangle kernel, not just the current
    flat/Gouraud path.
    - New Compile-time parameters section: lane count (multiple of 4,
    above a design minimum), i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
